Valar-Systems/valar-motion/hardware/val3100/PCB/VAL3100.kicad_pcb

## KiCad design hardware/val3100/PCB/VAL3100.kicad_pcb (2026-07-20)

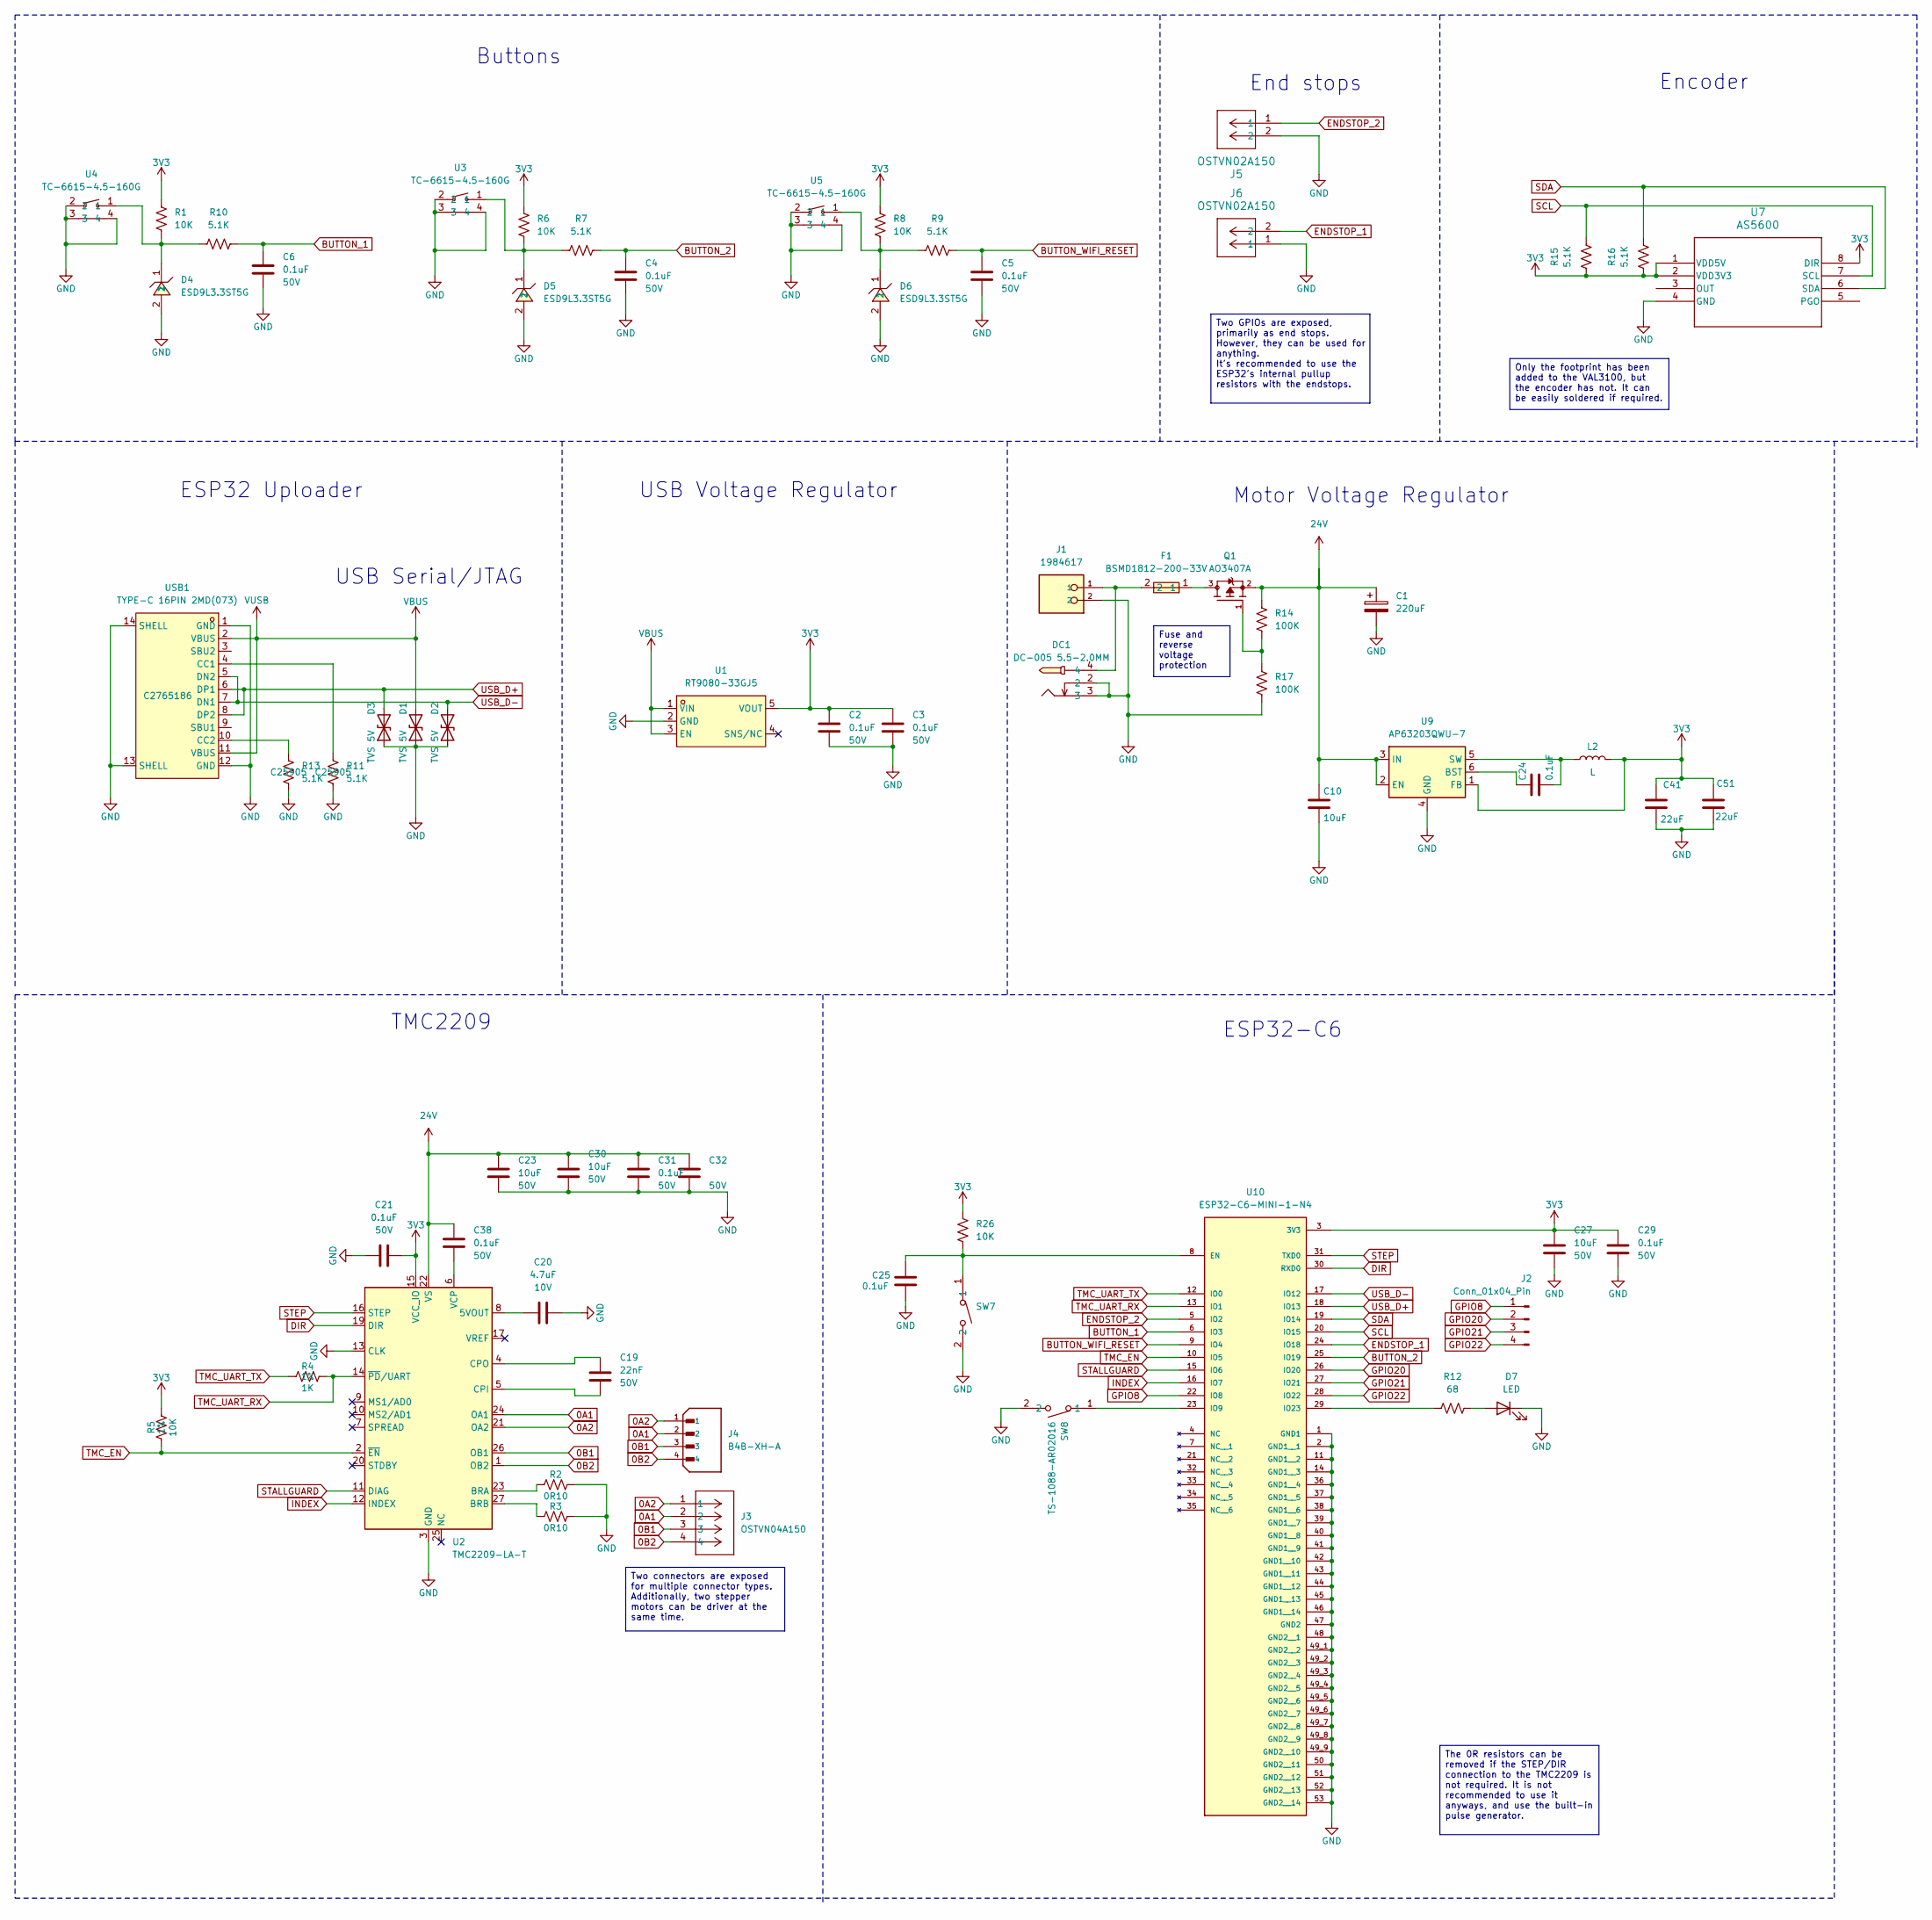
[picture p1: schematic VAL3100.kicad_sch]

Parts:
C1: 220uF; CAP-SMD_BD10.0-L10.3-W10.3-LS11.3-FD; Voltage 50V; LCSC C98743
C2, C3, C4, C5, C6, C21, C24, C29, C31, C32, C38: 0.1uF; C_0402_1005Metric; Voltage 50V; Tolerance 10%; LCSC C77020
C10: 10uF; C_0805_2012Metric; Voltage 50V; Tolerance 10%; LCSC C440198
C19: 22nF; C_0402_1005Metric; Voltage 50V; Tolerance 10%; LCSC C1532
C20: 4.7uF; C_0402_1005Metric; Voltage 10V; Tolerance 10%; LCSC C23733
C23, C27, C30: 10uF; C_0805_2012Metric; Voltage 50V; Tolerance 20%; LCSC C440198
C25: 0.1uF; C_0402_1005Metric; Voltage 50V; LCSC C77020
C41, C51: 22uF; C_0603_1608Metric; Voltage 10V; Tolerance 20%; LCSC C86295
D1, D2, D3: SOD-523_BSD5C051L; D_SOD-523; MPN BSD5C051L; LCSC C151983
D4, D5, D6: ESD9L3.3ST5G; SOD-923_L0.8-W0.6-LS1.0-RD; LCSC C233387
D7: LED; LED_0603_1608Metric; LCSC C2286
DC1: DC-005 5.5-2.0MM; DC-IN-TH_DC-005-5.5-2.0; LCSC C16214
F1: BSMD1812-200-33V; F1812; LCSC C7433877
J1: 1984617; PHOENIX_1984617; PARTREV 22.08.2018; LCSC C695629
J2: Conn_01x04_Pin; PinHeader_1x04_P2.54mm_Vertical
J3: OSTVN04A150; CONN_OSTVN04A150_OST; JLCPCB C918122
J4: B4B-XH-A; JST_B4B-XH-A; PARTREV 7/4/21; LCSC C144395
J5, J6: OSTVN02A150; CONN_OSTVN02A150_OST
L2: L; IND-SMD_L3.0-W3.0_FNR30XXS; LCSC C48020
Q1: AO3407A; SOT95P280X125-3N; PARTREV 5; LCSC C15155
R1, R5, R6, R8, R26: 10K; R_0402_1005Metric; LCSC C25744
R2, R3: 0R10; C_0805_2012Metric; LCSC C2074770
R4: 1K; R_0402_1005Metric; LCSC C11702
R7, R9, R10, R11, R13, R15, R16: 5.1K; R_0402_1005Metric; LCSC C25905
R12: 68; R_0402_1005Metric; LCSC C25131
R14, R17: 100K; R_0402_1005Metric; LCSC C25741
SW7, SW8: TS-1088-AR02016; SW-SMD_L3.9-W3.0-P4.45; LCSC C720477
U1: RT9080-33GJ5; TSOT-23-5_L2.9-W1.6-P0.95-LS2.8-BL; LCSC C841192
U2: TMC2209-LA-T; VQFN-28-1EP_5x5mm_P0.5mm_EP3.7x3.7mm_ThermalVias; LCSC C2150710
U3, U4, U5: TC-6615-4.5-160G; KEY-TH_TC-6615-4.5-160G; LCSC C6575012
U7: AS5600; AS5600L-ASOM_AMS; LCSC C79815
U9: AP63203QWU-7; TSOT-23-6; LCSC C780769
U10: ESP32-C6-MINI-1-N4; XCVR_ESP32-C6-MINI-1-N4; PARTREV 1.0; DigiKey_Part_Number 1965-ESP32-C6-MINI-1-N4CT-ND
USB1: TYPE-C 16PIN 2MD(073); USB-C-SMD_TYPE-C-6PIN-2MD-073; LCSC C2765186

Connections:
0A1: J3.2, J4.2, U2.24 (OA1)
0A2: J3.1, J4.1, U2.21 (OA2)
0B1: J3.3, J4.3, U2.26 (OB1)
0B2: J3.4, J4.4, U2.1 (OB2)
3V3: C2.2, C3.2, C21.2, C27.1, C29.1, C41.2, C51.2, L2.2, R1.1, R5.2, R6.1, R8.1, R15.1, R16.1, R26.1, U1.5 (VOUT), U2.15 (VCC_IO), U7.1 (VDD5V), U7.2 (VDD3V3), U7.8 (DIR), U9.1 (FB), U10.3 (3V3)
24V: C1.1, C10.1, C23.1, C30.1, C31.2, C32.2, C38.2, Q1.2, R14.2, U2.22 (VS), U2.28 (VS), U9.2 (EN), U9.3 (IN)
BUTTON_1: C6.2, R10.2, U10.6 (IO3)
BUTTON_2: C4.2, R7.2, U10.25 (IO19)
BUTTON_WIFI_RESET: C5.2, R9.2, U10.9 (IO4)
DIR: U2.19 (DIR), U10.30 (RXD0)
ENDSTOP_1: J6.2, U10.24 (IO18)
ENDSTOP_2: J5.1, U10.5 (IO2)
GND: C1.2, C2.1, C3.1, C4.1, C5.1, C6.1, C10.2, C20.2, C21.1, C23.2, C25.2, C27.2, C29.2, C30.2, C31.1, C32.1, C41.1, C51.1, D1.1 (A1), D2.1 (A1), D3.1 (A1), D4.2, D5.2, D6.2, D7.1 (K), DC1.2, DC1.3, J1.2, J5.2, J6.1, R2.2, R3.2, R11.2, R13.1, R17.1, SW7.2, SW8.2, U1.2 (GND), U2.3 (GND), U2.13 (CLK), U2.18 (GND), U2.29 (GND), U3.2, U3.3, U3.4, U4.2, U4.3, U4.4, U5.2, U5.3, U5.4, U7.4 (GND), U9.4 (GND), U10.1 (GND1), U10.2 (GND1__1), U10.11 (GND1__2), U10.14 (GND1__3), U10.36 (GND1__4), U10.37 (GND1__5), U10.38 (GND1__6), U10.39 (GND1__7), U10.40 (GND1__8), U10.41 (GND1__9), U10.42 (GND1__10), U10.43 (GND1__11), U10.44 (GND1__12), U10.45 (GND1__13), U10.46 (GND1__14), U10.47 (GND2), U10.48 (GND2__1), U10.49_1 (GND2__2), U10.49_2 (GND2__3), U10.49_3 (GND2__4), U10.49_4 (GND2__5), U10.49_5 (GND2__6), U10.49_6 (GND2__7), U10.49_7 (GND2__8), U10.49_8 (GND2__9), U10.49_9 (GND2__10), U10.50 (GND2__11), U10.51 (GND2__12), U10.52 (GND2__13), U10.53 (GND2__14), USB1.1 (GND), USB1.12 (GND), USB1.13 (SHELL), USB1.14 (SHELL)
GPIO8: J2.1, U10.22 (IO8)
GPIO20: J2.2, U10.26 (IO20)
GPIO21: J2.3, U10.27 (IO21)
GPIO22: J2.4, U10.28 (IO22)
INDEX: U2.12 (INDEX), U10.16 (IO7)
unnamed: D4.1, R1.2, R10.1, U4.1
unnamed: D5.1, R6.2, R7.1, U3.1
unnamed: D6.1, R8.2, R9.1, U5.1
unnamed: D7.2 (A), R12.2
unnamed: DC1.4, F1.2, J1.1
unnamed: F1.1, Q1.3
unnamed: Q1.1, R14.1, R17.2
unnamed: C20.1, U2.8 (5VOUT)
unnamed: R2.1, U2.23 (BRA)
unnamed: R3.1, U2.27 (BRB)
unnamed: C19.2, U2.5 (CPI)
unnamed: C19.1, U2.4 (CPO)
unnamed: C38.1, U2.6 (VCP)
unnamed: C24.1, U9.6 (BST)
unnamed: C24.2, L2.1, U9.5 (SW)
unnamed: C25.1, R26.2, SW7.1, U10.8 (EN)
unnamed: SW8.1, U10.23 (IO9)
unnamed: R12.1, U10.29 (IO23)
unnamed: R11.1, USB1.4 (CC1)
unnamed: R13.2, USB1.10 (CC2)
SCL: R15.2, U7.7 (SCL), U10.20 (IO15)
SDA: R16.2, U7.6 (SDA), U10.19 (IO14)
STALLGUARD: U2.11 (DIAG), U10.15 (IO6)
STEP: U2.16 (STEP), U10.31 (TXD0)
TMC_EN: R5.1, U2.2 (~EN), U10.10 (IO5)
TMC_UART_RX: R4.2, U2.14 (~PD/UART), U10.13 (IO1)
TMC_UART_TX: R4.1, U10.12 (IO0)
USB_D+: D3.2 (A2), U10.18 (IO13), USB1.6 (DP1), USB1.8 (DP2)
USB_D-: D2.2 (A2), U10.17 (IO12), USB1.5 (DN2), USB1.7 (DN1)
VBUS: D1.2 (A2), U1.1 (VIN), U1.3 (EN), USB1.2 (VBUS), USB1.11 (VBUS)

Notes on the sheet:
Motor Voltage Regulator
ESP32-C6
Buttons
TMC2209
ESP32 Uploader
End stops
USB Voltage Regulator
Encoder
USB Serial/JTAG
The 0R resistors can be removed if the STEP/DIR connection to the TMC2209 is not required. It is not recommended to use it anyways, and use the built-in pulse generator.
Two connectors are exposed for multiple connector types. Additionally, two stepper motors can be driver at the same time.
Only the footprint has been added to the VAL3100, but the encoder has not. It can be easily soldered if required.
Two GPIOs are exposed, primarily as end stops. However, they can be used for anything. It's recommended to use the ESP32's internal pullup resistors with the endstops.
Fuse and reverse voltage protection

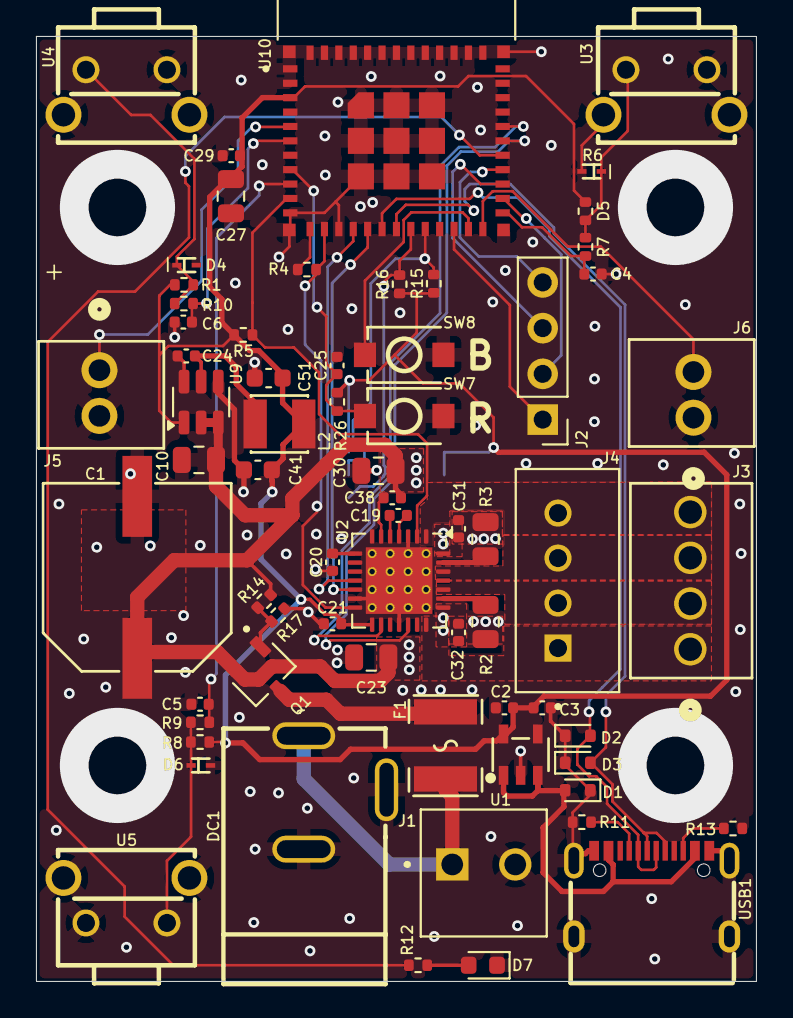
[picture p2: board VAL3100.kicad_pcb from above]

Board: 4 copper layers, 40.0 x 52.5 mm, 67 parts (1 on the bottom side), 48 nets.
