Valar-Systems/valar-motion/common/valar-core.yaml

# =============================================================================
# Valar Motion — ESPHome firmware (shared core)
# =============================================================================
#
# Board-independent core shared by every Valar Motion controller and every
# product built on the boards. Each per-board / per-product file sets the chip,
# GPIO pin map, and OTA identity via substitutions, then pulls this file in as a
# package:
#
#   substitutions: { device_name: …, pin_uart_tx: …, ota_asset: …, board_id: … }
#   packages: { core: !include ../../common/valar-core.yaml }
#
# LAYERS (see docs/FIRMWARE-POLICY.md):
#   1. valar-core.yaml  — THIS FILE. Universal: board infra, TMC2209 driver,
#      buttons, tuning, web UI, GitHub-OTA, diagnostics. Every build includes it.
#   2. common/scheduling.yaml — OPT-IN mixin (sun / time / open-close schedule).
#      Include it only when a product wants scheduling; it calls the product's
#      `schedule_open` / `schedule_close` scripts.
#   3. product layer — cover / homing / product-specific hardware, in the
#      product repo.
#
# A Wi-Fi (and, on the C6 boards, Thread/Zigbee-capable) stepper motor
# controller built around a TMC2209 driver. Control it from a browser at
# http://${device_name}-XXXXXX.local (XXXXXX = last 3 bytes of the MAC) — no
# Home Assistant required; pairs with HA over the native ESPHome API.
#
# -----------------------------------------------------------------------------
# Hardware (common to the family)
# -----------------------------------------------------------------------------
#   Driver : TMC2209, single-wire UART control (PDN_UART), StallGuard+StealthChop
#   Motor  : any 4-wire bipolar stepper; 200 full steps/rev, 8x microstep = 1600
#   Power  : 12–24 V, 2 A+ (2.1 x 5.5 mm barrel)
#   Flash  : USB-C (Improv over serial for Wi-Fi provisioning)
#
# GPIO signals (concrete pins supplied per-board via substitutions):
#   UART TX -> ${pin_uart_tx}   UART RX <- ${pin_uart_rx}   ENN ${pin_enn}
#   DIAG ${pin_diag}   INDEX ${pin_index}
#   Button 1 ${pin_btn1}   Button 2 ${pin_btn2}   Button 3 (Wi-Fi reset) ${pin_btn_wifi}
# =============================================================================

# Default substitutions — overridable by the including board/product file.
#   ota_repo   : GitHub owner/repo the "Update Firmware (GitHub)" button pulls
#                from. Generic board builds self-update from valar-motion's own
#                releases; a product overrides this to its own repo so its field
#                units keep fetching Product-*.ota.bin from where they always have.
#   fw_version : shown in the Diagnostics group; a product/release overrides it.
substitutions:
  ota_repo: "Valar-Systems/valar-motion"
  fw_version: "dev"

external_components:
  # Pinned to a specific commit so every rebuild is reproducible. Bump only
  # deliberately (and re-test all three boards) — never let it float.
  - source: github://slimcdk/esphome-custom-components@b5f0e44ae8732f68b9bbeaed9e962ca052d04cdb
    components: [tmc2209_hub, tmc2209, stepper]

esphome:
  name: ${device_name}
  friendly_name: ${friendly_name}
  name_add_mac_suffix: true
  # Explicit priority trigger (not the bare-action shorthand) so the optional
  # scheduling mixin's own late-priority on_boot trigger merges cleanly via
  # package concatenation instead of colliding with an action list.
  on_boot:
    - priority: 600.0
      then:
        - tmc2209.configure:
            direction: !lambda return id(global_stepper_direction);
            microsteps: 8
            interpolation: true
            tcool_threshold: !lambda "return id(global_tcoolthrs);"
        - tmc2209.stallguard:
            threshold: !lambda "return id(global_sgthrs);"
        - tmc2209.currents:
            standstill_mode: freewheeling
            irun: !lambda "return id(global_irun);"
            ihold: 0
            tpowerdown: 0
            iholddelay: 0
        - stepper.set_speed:
            id: driver
            speed: !lambda "return id(global_speed);"
        - stepper.set_acceleration:
            id: driver
            acceleration: !lambda "return id(global_acceleration);"
        # Publish the static diagnostic strings once (update_interval: never).
        - text_sensor.template.publish:
            id: firmware_version_text
            state: "${fw_version}"
        - text_sensor.template.publish:
            id: board_text
            state: "${board_id}"

esp32:
  board: ${esp_board}
  framework:
    type: esp-idf

# --- Connectivity / provisioning -------------------------------------------
wifi:
  ap: {}          # fallback hotspot; SSID defaults to the device name

captive_portal:
improv_serial:    # Wi-Fi setup over USB-C at https://web.esphome.io

api:              # no encryption key -> discoverable/adoptable out of the box

# Over-the-air updates. `esphome` handles dashboard/CLI uploads; `http_request`
# powers the "Update Firmware (GitHub)" button below (pull latest release asset).
ota:
  - platform: esphome
  - platform: http_request

# REQUIRED for http_request OTA to survive a power loss: ESP-IDF app-rollback
# boots a freshly-OTA'd image as PENDING_VERIFY and reverts it on the next reset
# unless it's marked valid. safe_mode marks it valid ~1 min after a healthy boot
# (and adds boot-loop recovery). Without it, GitHub-OTA updates silently revert.
safe_mode:

# HTTP client for the GitHub-OTA button. verify_ssl off (no bundled CA); larger
# buffers because GitHub 302-redirects to a long signed CDN URL that overflows
# the 512-byte default ("Out of buffer"); generous timeout for the ~1 MB image.
http_request:
  verify_ssl: false
  timeout: 10min
  buffer_size_rx: 4096
  buffer_size_tx: 4096

logger:
  hardware_uart: ${log_uart}   # keep logs + Improv on the USB-C port
  # The chatty number/text_sensor/sensor entities re-publish every update_interval
  # and would flood the log at idle; raise just those tags to INFO. Live values
  # are still visible in the web UI / HA — only routine log spam is hidden.
  logs:
    number: INFO
    text_sensor: INFO
    sensor: INFO

# Browser-based control panel at http://${device_name}-XXXXXX.local — exposes
# every entity without Home Assistant. version 3 = grouped, collapsible UI; each
# entity picks a group via web_server.sorting_group_id. The optional scheduling
# mixin appends its own "Schedule" group to this list via package merge.
web_server:
  port: 80
  version: 3
  sorting_groups:
    - { id: group_control,     name: "Control",       sorting_weight: 10 }
    - { id: group_setup,       name: "Setup",         sorting_weight: 20 }
    - { id: group_motion,      name: "Motion Tuning", sorting_weight: 30 }
    - { id: group_stallguard,  name: "StallGuard",    sorting_weight: 40 }
    - { id: group_diagnostics, name: "Diagnostics",   sorting_weight: 60 }

# --- Shared state -----------------------------------------------------------
globals:
  - { id: global_irun,          type: int,   restore_value: yes, initial_value: '25' }
  - { id: global_speed,         type: int,   restore_value: yes, initial_value: '1500' }
  - { id: global_acceleration,  type: int,   restore_value: yes, initial_value: '1500' }
  - { id: global_tcoolthrs,     type: int,   restore_value: yes, initial_value: '100' }
  - { id: global_sgthrs,        type: int,   restore_value: yes, initial_value: '100' }
  - id: global_stepper_direction
    type: esphome::tmc2209::ShaftDirection
    restore_value: yes
    initial_value: 'esphome::tmc2209::ShaftDirection::CLOCKWISE'

uart:
  tx_pin: ${pin_uart_tx}
  rx_pin: ${pin_uart_rx}
  baud_rate: 500000

stepper:
  - platform: tmc2209
    id: driver
    max_speed: 2000 steps/s
    acceleration: 2000 steps/s^2
    deceleration: 3000 steps/s^2
    config_dump_include_registers: true
    rsense: 100 mOhm
    vsense: False
    enn_pin: ${pin_enn}
    index_pin: ${pin_index}
    diag_pin: ${pin_diag}
    # NOTE (rewire): products that need a different stall response (e.g. the
    # Ropener zeroes/reports position for homing) will override this hook. The
    # exact override mechanism (!extend vs. a script contract) gets prototyped
    # during the Ropener rewire — this default stays put for the generic build.
    on_stall:
      - stepper.stop: driver
      - stepper.report_position: { id: driver, position: 0 }
      - logger.log: "Stall detected — stopped and zeroed"

# Physical buttons — BARE entities (pins + debounce, with ids, no baked-in
# actions). Behaviour belongs to the product/board layer: a product attaches
# on_press/on_click/on_release by `!extend`-ing these ids (btn1/btn2/btn3). The
# generic board build leaves them as plain state-reporting inputs.
binary_sensor:
  - platform: gpio
    id: btn1
    name: "Button 1"
    web_server: { sorting_weight: 1, sorting_group_id: group_control }
    pin:
      number: ${pin_btn1}
      mode: INPUT
      inverted: true
    filters:
      - delayed_on: 10ms
  - platform: gpio
    id: btn2
    name: "Button 2"
    web_server: { sorting_weight: 2, sorting_group_id: group_control }
    pin:
      number: ${pin_btn2}
      mode: INPUT
      inverted: true
    filters:
      - delayed_on: 10ms
  - platform: gpio
    id: btn3
    name: "Button 3 (Wi-Fi reset)"
    web_server: { sorting_weight: 3, sorting_group_id: group_control }
    pin:
      number: ${pin_btn_wifi}
      mode: INPUT
      inverted: true
    filters:
      - delayed_on: 10ms

# --- Tuning controls (identical on every board) -----------------------------
number:
  - platform: template
    id: num_speed
    name: "Speed"
    web_server: { sorting_weight: 1, sorting_group_id: group_motion }
    min_value: 100
    max_value: 10000
    step: 100
    mode: SLIDER
    entity_category: CONFIG
    lambda: return id(global_speed);
    update_interval: 1s
    set_action:
      - globals.set: { id: global_speed, value: !lambda "return x;" }
      - stepper.set_speed: { id: driver, speed: !lambda "return id(global_speed);" }
  - platform: template
    id: num_accel
    name: "Acceleration"
    web_server: { sorting_weight: 2, sorting_group_id: group_motion }
    min_value: 100
    max_value: 10000
    step: 100
    mode: SLIDER
    entity_category: CONFIG
    lambda: return id(global_acceleration);
    update_interval: 1s
    set_action:
      - globals.set: { id: global_acceleration, value: !lambda "return x;" }
      - stepper.set_acceleration: { id: driver, acceleration: !lambda "return id(global_acceleration);" }
  - platform: template
    id: num_irun
    name: "IRUN (motor current)"
    web_server: { sorting_weight: 1, sorting_group_id: group_stallguard }
    min_value: 1
    max_value: 31
    step: 1
    mode: BOX
    entity_category: CONFIG
    lambda: return id(driver)->read_field(IRUN_FIELD);
    update_interval: 1s
    set_action:
      - globals.set: { id: global_irun, value: !lambda "return x;" }
      - tmc2209.currents: { irun: !lambda "return id(global_irun);" }
  - platform: template
    id: num_tcoolthrs
    name: "TCOOLTHRS"
    web_server: { sorting_weight: 3, sorting_group_id: group_stallguard }
    min_value: 0
    max_value: 1048575
    step: 1
    mode: BOX
    entity_category: CONFIG
    lambda: return id(driver)->read_register(TCOOLTHRS);
    update_interval: 30s   # config value read over UART; poll slowly
    set_action:
      - globals.set: { id: global_tcoolthrs, value: !lambda "return x;" }
      - lambda: id(driver)->write_register(TCOOLTHRS, x);
  - platform: template
    id: num_sgthrs
    name: "SGTHRS (stall threshold)"
    web_server: { sorting_weight: 2, sorting_group_id: group_stallguard }
    min_value: 0
    max_value: 255
    step: 1
    mode: SLIDER
    entity_category: CONFIG
    lambda: return id(driver)->read_register(SGTHRS);
    update_interval: 1s
    set_action:
      - globals.set: { id: global_sgthrs, value: !lambda "return x;" }
      - lambda: id(driver)->write_register(SGTHRS, x);

# Motor Direction — a mirror of global_stepper_direction (single source of truth,
# applied in on_boot). Modelled as a SELECT, not a switch: a template switch
# defaults to an ALWAYS_OFF restore that re-runs turn_off_action every boot and
# would clobber the restored direction back to CLOCKWISE. The select carries no
# state of its own — it reads the global and writes it on change — so it never
# fights the restored value.
select:
  - platform: template
    id: sel_direction
    name: "Motor Direction"
    web_server: { sorting_weight: 1, sorting_group_id: group_setup }
    entity_category: CONFIG
    update_interval: 1s
    options:
      - "Normal"
      - "Reversed"
    lambda: |-
      if (id(global_stepper_direction) == esphome::tmc2209::ShaftDirection::COUNTERCLOCKWISE)
        return std::string("Reversed");
      return std::string("Normal");
    set_action:
      - lambda: |-
          id(global_stepper_direction) = (x.find("Reversed") != std::string::npos)
            ? esphome::tmc2209::ShaftDirection::COUNTERCLOCKWISE
            : esphome::tmc2209::ShaftDirection::CLOCKWISE;
      - tmc2209.configure:
          direction: !lambda return id(global_stepper_direction);
      - lambda: |-
          // Persist immediately: update() stages the changed global, sync()
          // flushes NVS now so the choice survives an unplug seconds later.
          global_stepper_direction->update();
          global_preferences->sync();

button:
  # Pull the latest released firmware for this build straight from GitHub and
  # flash it OTA. Points at the version-less "latest" asset so the URL never
  # changes between releases. ${ota_repo}/${ota_asset} make the target
  # per-build: generic boards -> valar-motion/valXXXX; a product overrides
  # ota_repo/ota_asset to keep its own field-OTA URL byte-for-byte stable.
  - platform: template
    name: "Update Firmware (GitHub)"
    web_server: { sorting_weight: 7, sorting_group_id: group_diagnostics }
    entity_category: DIAGNOSTIC
    on_press:
      - logger.log: "Checking GitHub for the latest firmware..."
      - ota.http_request.flash:
          md5_url: https://github.com/${ota_repo}/releases/latest/download/${ota_asset}.ota.bin.md5
          url: https://github.com/${ota_repo}/releases/latest/download/${ota_asset}.ota.bin
  - platform: restart
    name: "Restart"
    web_server: { sorting_weight: 8, sorting_group_id: group_diagnostics }
    entity_category: DIAGNOSTIC

text_sensor:
  # Static strings published once from on_boot (update_interval: never).
  - platform: template
    name: "Firmware Version"
    id: firmware_version_text
    icon: "mdi:chip"
    entity_category: DIAGNOSTIC
    web_server: { sorting_weight: 4, sorting_group_id: group_diagnostics }
    update_interval: never
  - platform: template
    name: "Board"
    id: board_text
    icon: "mdi:developer-board"
    entity_category: DIAGNOSTIC
    web_server: { sorting_weight: 6, sorting_group_id: group_diagnostics }
    update_interval: never
  - platform: wifi_info
    ip_address:
      name: "IP Address"
      entity_category: DIAGNOSTIC
      web_server: { sorting_weight: 10, sorting_group_id: group_diagnostics }
    ssid:
      name: "Connected SSID"
      entity_category: DIAGNOSTIC
      web_server: { sorting_weight: 11, sorting_group_id: group_diagnostics }
    mac_address:
      name: "MAC Address"
      entity_category: DIAGNOSTIC
      web_server: { sorting_weight: 12, sorting_group_id: group_diagnostics }

sensor:
  # TMC2209 register readouts — tune StallGuard by watching SG_RESULT under load.
  - platform: template
    id: sen_sgresult
    name: "SG_RESULT"
    lambda: return id(driver)->read_register(SG_RESULT);
    update_interval: 1s
    entity_category: DIAGNOSTIC
    web_server: { sorting_weight: 1, sorting_group_id: group_diagnostics }
  - platform: template
    id: sen_tstep
    name: "TSTEP"
    lambda: return id(driver)->read_register(TSTEP);
    update_interval: 1s
    entity_category: DIAGNOSTIC
    web_server: { sorting_weight: 2, sorting_group_id: group_diagnostics }
  # Standard device diagnostics.
  - platform: wifi_signal
    name: "WiFi Signal"
    update_interval: 60s
    entity_category: DIAGNOSTIC
    web_server: { sorting_weight: 13, sorting_group_id: group_diagnostics }
  - platform: uptime
    name: "Uptime"
    entity_category: DIAGNOSTIC
    web_server: { sorting_weight: 14, sorting_group_id: group_diagnostics }
  - platform: internal_temperature
    name: "ESP Internal Temperature"
    entity_category: DIAGNOSTIC
    web_server: { sorting_weight: 15, sorting_group_id: group_diagnostics }
