Valar-Systems/valar-motion/(commit log)

2026-07-20 Add valar-motion scaffold and migrate VAL3000/VAL3100 hardware + docs
    Stand up the Valar Motion mono-repo: shared ESPHome core
    (common/valar-core.yaml), three thin board wrappers (val3000/3100/3101),
    CI build matrix, and governing docs.
    - Migrate VAL3000 hardware (KiCad source + AS5600 library) and docs into
    hardware/val3000/ and docs/val3000/
    - Migrate VAL3100 hardware into hardware/val3100/
    - VAL3101 shares the VAL3100 board with the AS5600 populated; encoder I2C
    pins set to SDA=GPIO14 / SCL=GPIO15 (read from the VAL3100 schematic)
    - Pin downstream example package refs to v0.1.0
    - Exclude KiCad auto-save backups, project-local .prl, locks, and caches
    (they remain in the original boa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
2026-07-20 Fix CI: locate ESPHome build dir under boards/<board>/.esphome
    The compile step succeeds for all three boards, but "Collect binaries"
    looked for firmware.factory.bin at .esphome/build/<b>/... (repo root).
    ESPHome writes build output next to the board YAML, so the real path is
    boards/<b>/.esphome/build/<b>/.pioenvs/<b>/. Locate it with find so the
    step is robust to layout changes.
    Claude-Session: https://claude.ai/code/session_01XpCz2RvuxV5uV8bFwCEpkL
2026-07-20 README: add product photos and family-level info from VAL3000
    Rework the front page from a bare spec table into a proper product README:
    hero shot of the board driving a NEMA-17, the annotated board-anatomy
    diagram, component overview, quick-start, StallGuard/safety notes, motor
    connector options, and hardware/docs links. Photos migrated from the
    VAL3000 repo (docs/val3000/media). Also correct the build-output path to
    boards/<board>/.esphome/build/... to match ESPHome's layout.
    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
2026-07-20 docs: add hardware guide migrated from the VAL3000 wiki
    Preserve the durable technical content from the VAL3000 wiki (which would
    otherwise only live in the archived wiki) as docs/hardware-guide.md, and
    link it from the README. Adapted for the mono-repo: pinout is marked
    ESP32-C3/VAL3000-specific (C6 boards differ — see boards/*.yaml), the
    UART-vs-STEP/DIR distinction is called out, and the old VAL3000-only
    firmware-variant list is dropped.
    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
2026-07-20 Grow valar-core (web UI, GitHub-OTA, diagnostics) + add opt-in scheduling mixin
    Layer 1 of the 3-layer split from the approved shared-vs-product map. valar-core
    gains the infrastructure both products duplicated, so it stays universal:
    - web_server v3 with grouped UI (Control/Setup/Motion/StallGuard/Diagnostics)
    - http_request + safe_mode + "Update Firmware (GitHub)" button, parameterized
    via ${ota_repo}/${ota_asset} (generic boards -> valar-motion/valXXXX; a product
    overrides ota_repo to keep its own field-OTA URL byte-for-byte)
    - shared diagnostics: Firmware Version, Board, WiFi Signal, wifi_info (IP/SSID/
    MAC), Uptime, ESP Internal Temperature, Restart, TSTEP/SG_RESULT
    - Motor Direc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
2026-07-20 CI: inject the git tag as fw_version on tag builds
    On a tagged release build, pass `-s fw_version <tag>` so the "Firmware Version"
    diagnostic baked into the shipped .bin matches the release a device is running
    (and the GitHub-OTA asset it pulls). Branch/PR builds keep the core default
    "dev" — honest for a non-release build. The -s flag must precede the subcommand.
    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
2026-07-20 docs: board-specific connectors + reverse-polarity protection [skip ci]
    - Reverse-polarity protection is VAL3100/VAL3101 only; the VAL3000 has none.
    Make the README + hardware-guide warnings board-specific.
    - VAL3100/3101 ship with a 4-pin screw terminal pre-soldered for the motor
    (plus JST-XH); VAL3000 has JST-XH (screw terminal included to solder on).
    - Note the 2-pin screw terminal for power alongside the barrel jack.
    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
2026-07-20 core: expose ids on shared entities, bare buttons, add TCOOLTHRS
    Prep for products consuming valar-core as a remote package and overriding via
    !extend (proven mechanism):
    - add ids to the shared entities products rename/override: btn1/btn2/btn3,
    num_speed/num_accel/num_irun/num_tcoolthrs/num_sgthrs, sel_direction,
    sen_sgresult/sen_tstep
    - buttons are now BARE (pins + debounce only); behaviour moves to the
    product/board layer, attached via !extend. Generic board buttons report state
    with no default action.
    - add a shared TCOOLTHRS number (both products expose it)
    Validated: esphome config passes on val3000/val3100/val3101.
    Clau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
2026-07-22 core v0.3.0: parameterize stepper hardware constants + default direction
    Extract the driver's compile-time hardware values and the power-on motor
    direction into substitutions so a product on different hardware can override
    them from its board file, without editing core.
    New substitutions (defaults preserve current VAL30xx behaviour exactly):
    stepper_rsense "100 mOhm"
    stepper_vsense "false"
    stepper_deceleration "3000 steps/s^2" (accepts "inf" for immediate stop)
    stepper_max_speed "2000 steps/s"
    stepper_acceleration "2000 steps/s^2"
    stepper_config_dump "true"
    motor_direction_default "CLOCKWISE" (COUNTERCLOCKWISE for reversed HW)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
2026-09-03 Updated schematic
